gokulg846/compact-edge-enclosure/report/walkthrough.md

# A five-minute explanation

Use the current report and CAD images. The goal is to explain the design, not recite the file count.

**0:00–0:40 — State the problem.** “This is a digital study of a small enclosure for an assumed electronics board. The main constraints are a 100 × 70 × 25 mm housing, removable electronics and an 8 W heat-load scenario. These are design inputs, not measurements of a commercial device.” Show the assembly image.

**0:40–1:25 — Explain the parts.** Show the exploded view. “The tray supports the board and provides mounting and connector access. The lid has an underside contact block and external fins. A compliant pad connects the chip to that block. Four screws let the lid come off for service.” Point to each part. Explain that the inspection fixture is separate tooling, not part of the product.

**1:25–2:10 — Explain the difficult gap.** Show the section drawing. “The nominal thermal gap is 0.50 mm. The proposed tolerance stack gives 0.31–0.69 mm. That matters because pad compression creates force on the board. A nominal thickness alone is insufficient to select the pad.” Show how the dimensions subtract; do not claim a pad supplier or pressure test.

**2:10–3:05 — Explain the thermal assumptions.** “The original resistance scenarios give93.4°C passive and61.4°C with the lower fan resistance, at 8 W and35°C ambient. Those are conditional calculations. I added a geometric area check: the modeled lid path needs an effective heat-transfer coefficient of about 26.5 W/(m² K) to meet80°C under the stated assumptions. Actual airflow and fin efficiency are not established.” Show the design-study plot and name its simplifications.

**3:05–3:50 — Explain a real tradeoff.** “I rebuilt a four-fin option and a taller-fin option. Four fins give wider tool channels but less exposed area. Taller fins add area but make the housing 29 mm high. Eight fins leave 2 mm channels, below the chosen 3 mm cutter constraint. The six-fin design remains the baseline, not a proven optimum.” Open the candidate result table.

**3:50–4:25 — Explain manufacturing intent.** Show the setup diagram. “The tray needs a top pocket, an underside finishing setup and a side connector operation. The thin thermal lid needs support while machining its second side. These are process proposals. No machine-specific CAM, feeds/speeds or proved toolpaths are claimed.”

**4:25–5:00 — Explain evidence and scope.** “The source regenerates the geometry and reports. Solid checks verify nominal shape validity and overlap; software tests verify specific calculations and input rules. They do not prove strength, actual temperatures or manufacturability. This project is a digital design study with its open decisions documented.” Mention AI assistance accurately if discussing how it was produced; focus on decisions you can personally explain and reproduce.

## Before presenting

Be able to answer: Why is the lid removable? What are the four layers? Why does the pad gap matter? Where did 8 W come from? Which temperature is being estimated? Why was the eight-fin candidate rejected? What does a passing interference check fail to establish? The answers are in START_HERE.md and analysis/design-study.md.
