gokulg846/compact-edge-enclosure/report/sources.md

# Public context and technical sources

Accessed 2026-10-09. Company pages informed the problem context only; no geometry was copied and no undisclosed specifications were inferred.

- [comma.ai home](https://comma.ai/): camera-based driver-assistance hardware context.
- [Introducing comma four](https://blog.comma.ai/comma-four/), published 2025-11-25: describes mechanical/thermal redesign, compact integration and San Diego manufacture. This motivated studying packaging, thermal paths and assembly; it does not establish dimensions or heat loads for this project.
- [comma.ai shop](https://comma.ai/shop): product context; prices/specifications are not design inputs here.
- [commaai/hardware](https://github.com/commaai/hardware): public hardware repository reviewed as a contextual reference. No CAD assets imported.
- [comma.ai jobs](https://comma.ai/jobs): current public page lists Prototyping Engineer in San Diego. The Haas reference is supplied by the user's brief; the public listing inspected did not substantiate a machine configuration.
- [Haas VF-2](https://www.haascnc.com/machines/vertical-mills/vf-series/models/small/vf-2.html): reference machine family only. Actual configuration must be checked at the shop.
- [CadQuery quick start](https://cadquery.readthedocs.io/en/latest/quickstart.html) and [import/export documentation](https://cadquery.readthedocs.io/en/latest/importexport.html): editable Python solids and genuine STEP/STL/DXF export workflow.

All performance resistances, tolerances, interface dimensions, fastener envelopes, weights/scores and acceptance targets in the project are declared engineering assumptions or proposals. No vendor pad/fan/material property is represented as verified without selection and datasheet review.
