gokulg846/compact-edge-enclosure/docs/review-notes.md

# Digital review / Rev C

This revision addresses the difficulty of understanding the first repository and corrects specific engineering/software issues. The nominal enclosure dimensions have not changed.

| Finding | Correction | Evidence |
|---|---|---|
| The front page emphasized artifact/test counts instead of the design | Replaced it with a short problem statement, results table and a three-document reading path | README and START_HERE |
| Dozens of individual screw and locator exports obscured the two custom parts | Grouped component STEP, mesh and profile exports; added a single fixture assembly | exports/ and build.py |
| Compressed source lines were difficult to read | Applied normal Python formatting and documented model/analysis entry points | CAD, analysis and scripts |
| `lid_boss_radius` no longer controlled the actual corner geometry | Replaced it with `corner_island_width`; shared the true cavity between CAD and SCAD generation | CAD regression test changes actual solid volume |
| A shifted lid pilot could be accepted without enough surrounding material | Added actual B-rep ring containment at all four lid pilots | A hole shifted into the pocket is rejected by a regression test |
| Pad-gap arithmetic duplicated hard-coded nominal dimensions | Derived nominal gap from the CAD parameters and moved tolerance assumptions to a named input file | Changing the CAD gap changes the analysis result in a regression test |
| A validation comment implied a cutter-collision check that did not exist | Corrected it to describe scalar radius/channel checks | validate.py; CAM limitations retained |
| The thermal scenarios lacked a link to fin geometry | Added exposed-area and required-conductance calculations plus rebuilt fin candidates | design-study.json and design-study.csv |
| Arbitrary parameter edits could leave report dimensions stale | Added a reviewed-input check before PDF generation | report input-guard test |
| Portfolio copy framed physical work as the required next milestone | Reframed the project as a bounded digital design study | README, report, summary and walkthrough |

The study still does not establish a real board interface, supplier-qualified pad behavior, actual convection, machining capability, thread strength or fixture repeatability. Digital rigor means stating those boundaries and checking the claims we can check; it does not mean labeling the product “perfect.”

No past physical work or engineering experience has been invented. The geometry and documents were developed with AI assistance and are intended for owner review and understanding before use in an application.
