gokulg846/compact-edge-enclosure/images/base_drawing.png

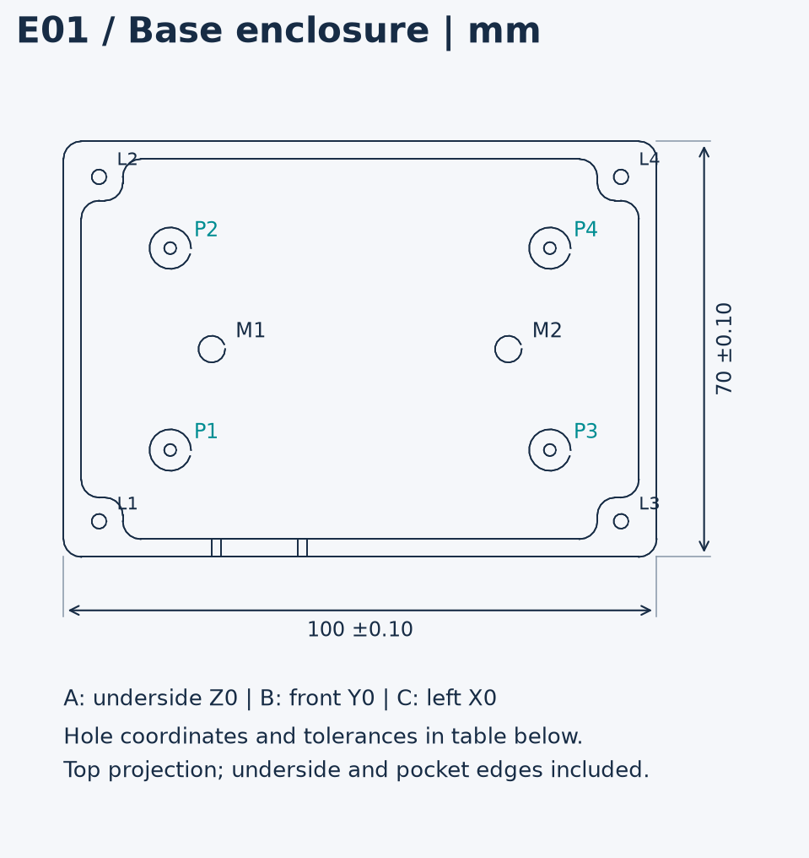
images/base_drawing.png
