gokulg846/compact-edge-enclosure/images/concept_matrix.png

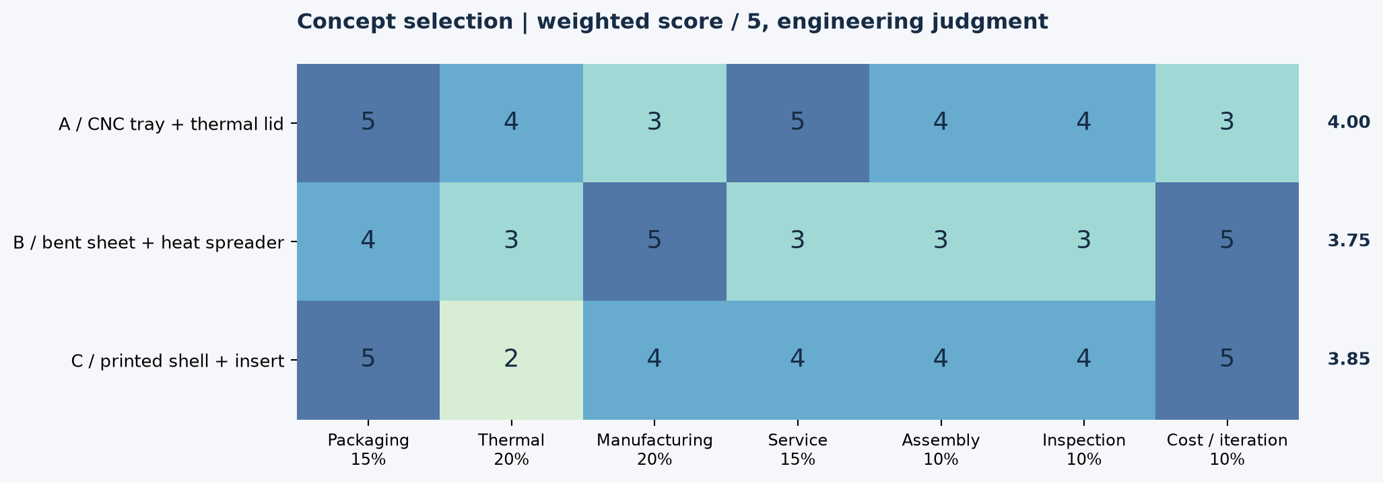
images/concept_matrix.png
