gokulg846/compact-edge-enclosure/images/dimensioned_plan.png

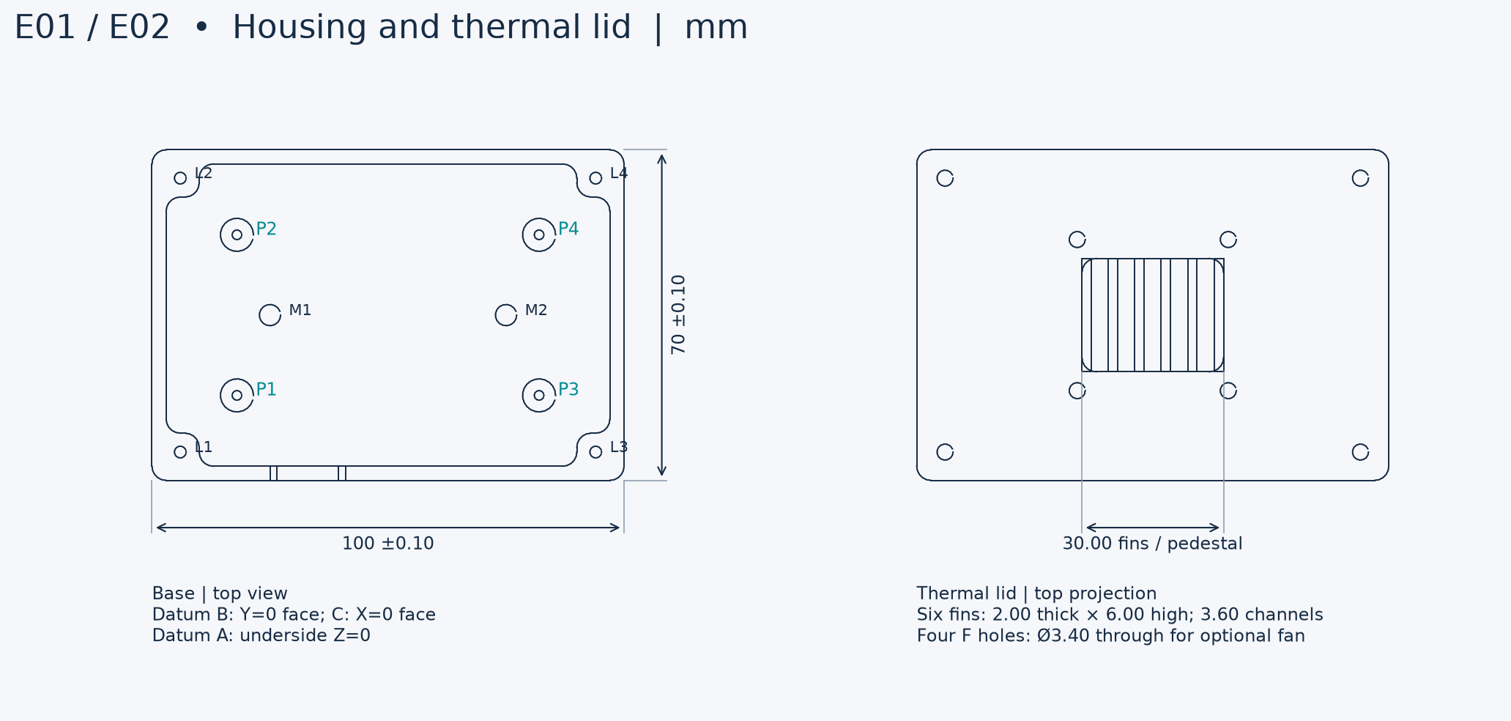
images/dimensioned_plan.png
