gokulg846/compact-edge-enclosure/images/dimensioned_section.png

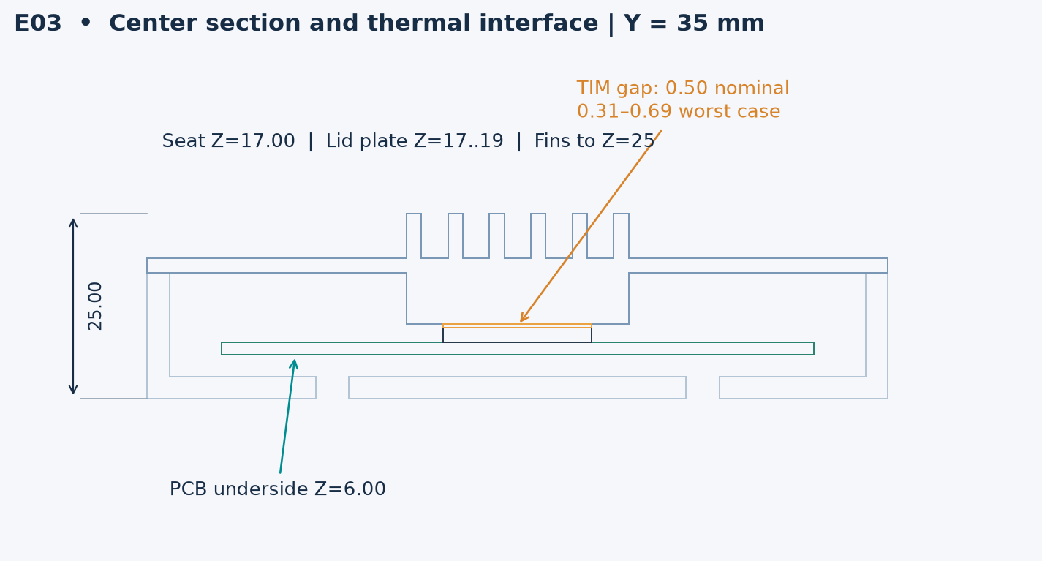
images/dimensioned_section.png
