gokulg846/compact-edge-enclosure/images/fixture_layout.png

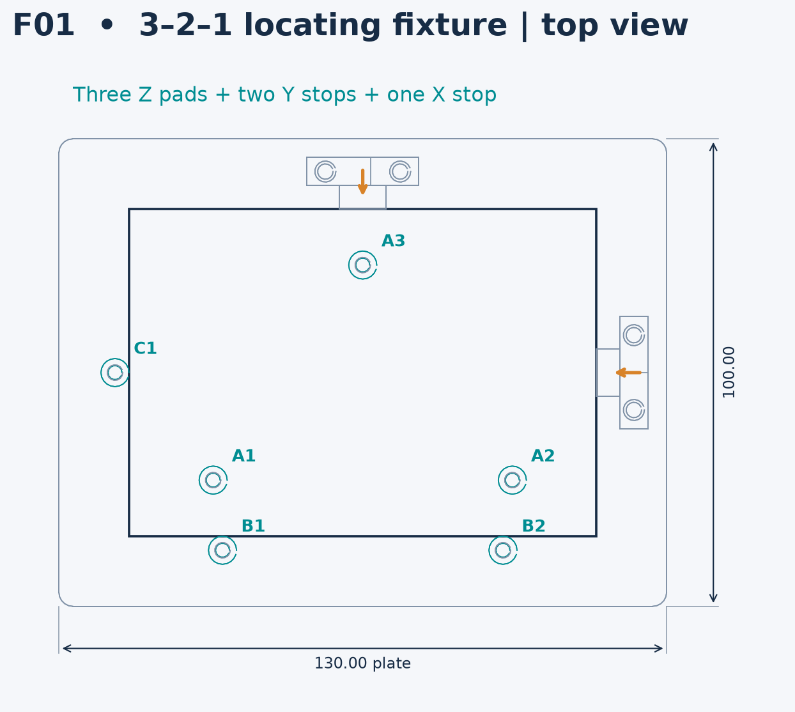
images/fixture_layout.png
