gokulg846/compact-edge-enclosure/images/forced_air.png

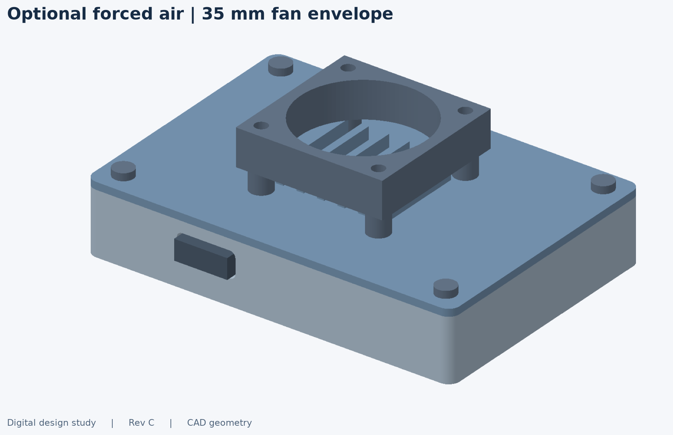
images/forced_air.png
