gokulg846/compact-edge-enclosure/images/thermal_lid_drawing.png

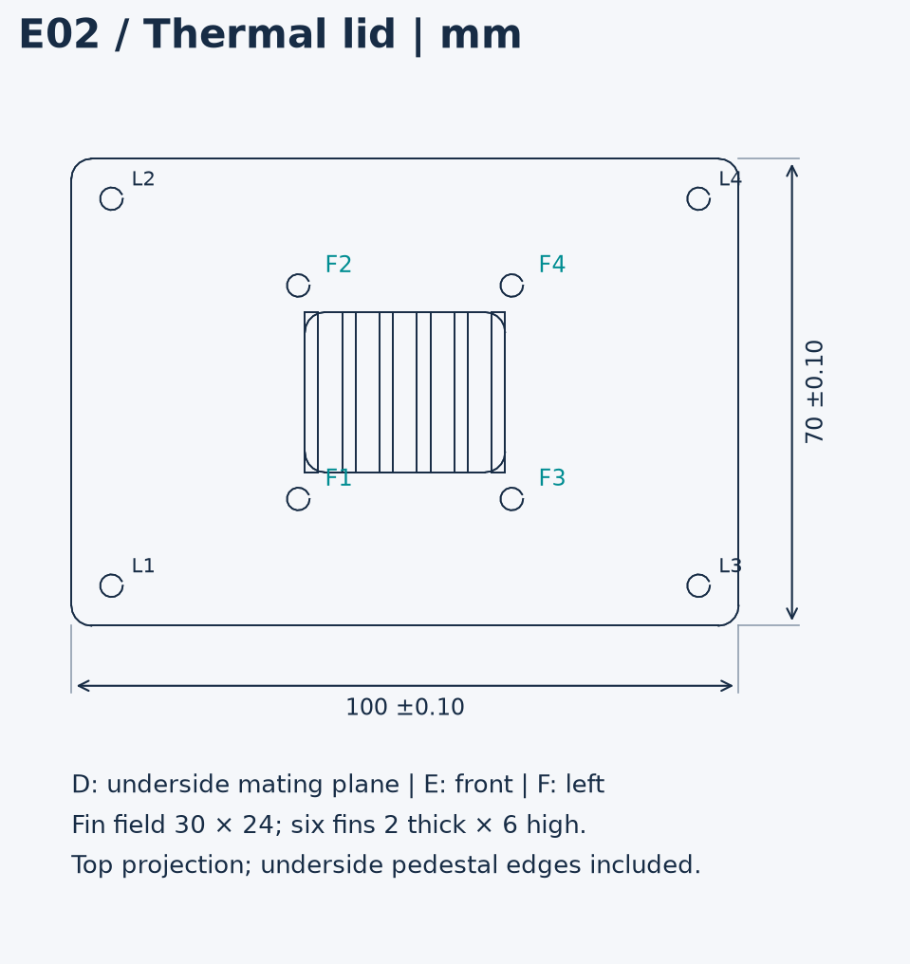
images/thermal_lid_drawing.png
