gokulg846/compact-edge-enclosure/images/thermal_sensitivity.png

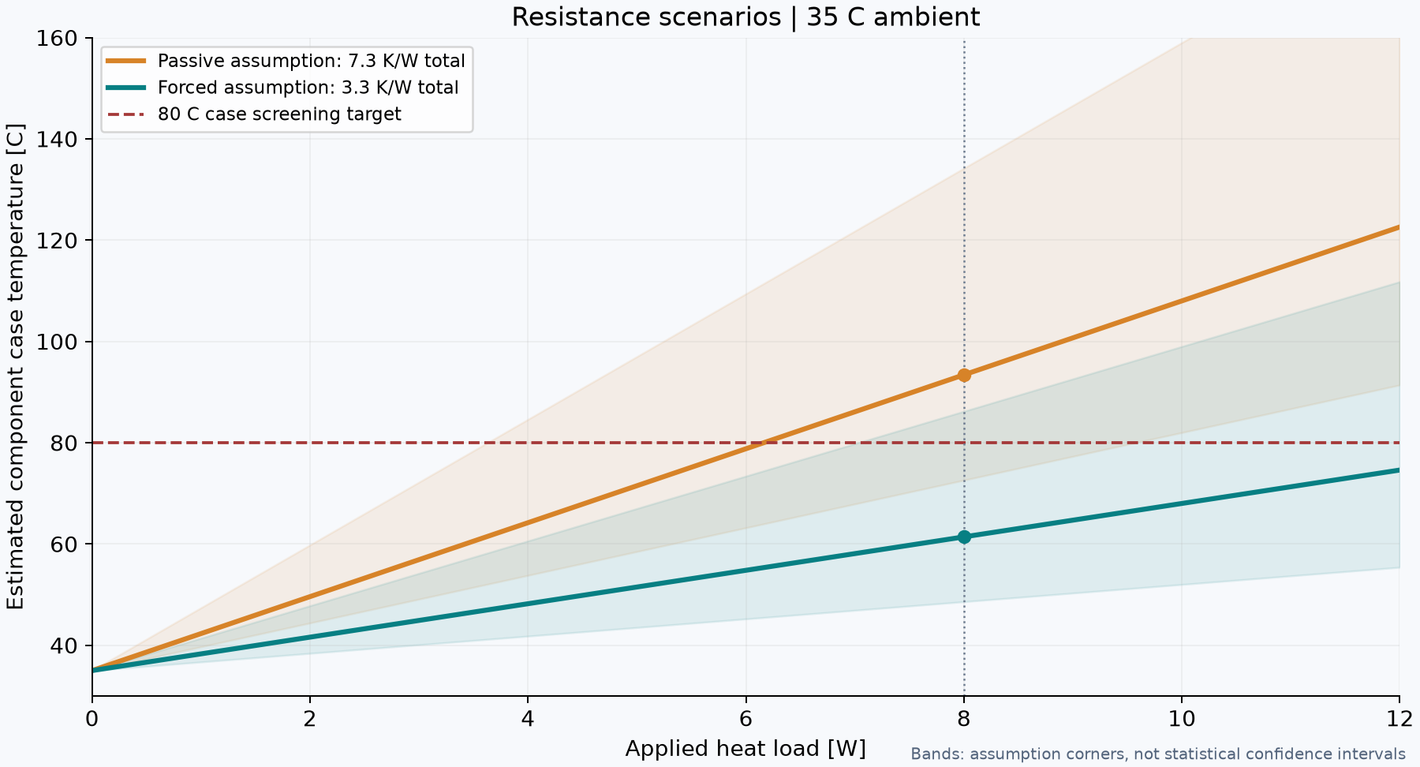
images/thermal_sensitivity.png
