gokulg846/compact-edge-enclosure/manufacturing/bom.md

# Candidate bill of materials / no purchase or build claimed

| Qty | Item | Geometry / selection note |
|---:|---|---|
| 1 | CNC tray | 6061-T6; exports/base.step; replace with fit print initially |
| 1 | Integral thermal lid | 6061-T6; exports/thermal_lid.step; printed copy is dummy only |
| 1 | Generic board coupon | 80 × 50 × 1.6; hole pattern64 × 34; not a real compute board specification |
| 1 | Dummy chip / heater block | 20 × 20 × 2 envelope; heater and electrical ratings to be selected |
| 1 | Thermal pad | 20 × 20; free 1 mm assumed; supplier compression/pressure/temperature data required |
| 4 | M3 × 8 lid screws | Selected head envelope ≤Ø5.5 × 2 assumed; verify actual fastener |
| 4 | M2.5 × 5 PCB screws | Head envelope ≤Ø4.5 × 1.7 assumed; verify actual fastener |
| 2 | M4 external mount bolts | Length to external bracket; head height ≤2.5; bracket/nuts not included |
| 1 optional | Generic fan | 40 × 40 × 10; pitch 32; actual fan/guard/power/flow not selected |
| 4 optional | Fan spacers | Length6; OD6; ID3.4 |
| 4 sets optional | Fan M3 bolts/nuts | Nominal grip 18 mm plus washers/nut; select length after measuring actual hardware |
| 1 | Fixture plate | 130 × 100 × 6; exports/components/fixture_plate.step |
| 6 | Replaceable locator buttons | Ø6 shoulders, simplifiedØ3 stems; three 4 mm and three 9 mm above plate |
| 6 sets | Locator nuts/washers/shims | Selected to fit4 mm stem protrusion beneath plate; raise bench fixture for access |
| 2 | Lateral clamp blocks | Modeled mounting and horizontal screw bores; M4 hardware to be selected |
| 2 | Replaceable clamp pads | Nylon/acetal candidate, low force; swivel attachment requires selection |
| 4 | Clamp-block mounting screws | M4 clearance blocks to tapped plate; select length against6 mm plate thickness |
| 2 | Clamp drive screws | M4; verify travel, pad attachment and applied force |
| As needed | Bench feet / light hold-down | Not modeled; required where nuts need clearance or assembly torque could lift tray |

No supplier pricing or lead-time quote has been obtained. Print cost is dominated by material/time; CNC cost by setup count and thin-lid fixturing. Obtain quotes using the STEP files plus review drawings after real interfaces are frozen.
