gokulg846/compact-edge-enclosure/exports/assembly.step

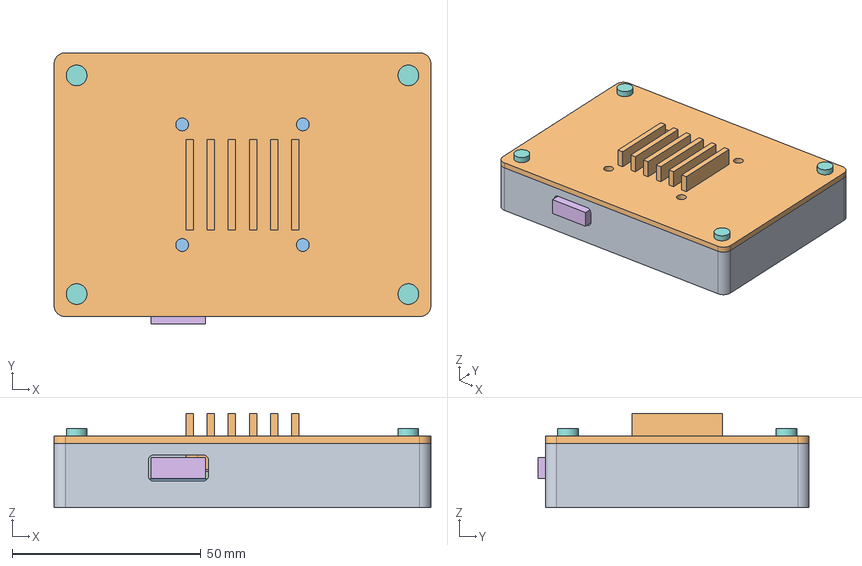
[picture p26: CAD file, 2026-10-09]
exports/assembly.step
100.0 x 72.0 x 25.0 mm
base
thermal_lid
pcb
chip
thermal_pad
connector
component_keepout
lid_screw_1
lid_screw_2
lid_screw_3
lid_screw_4
pcb_screw_1
pcb_screw_2
pcb_screw_3
pcb_screw_4
