gokulg846/compact-edge-enclosure/exports/forced_air_assembly.step

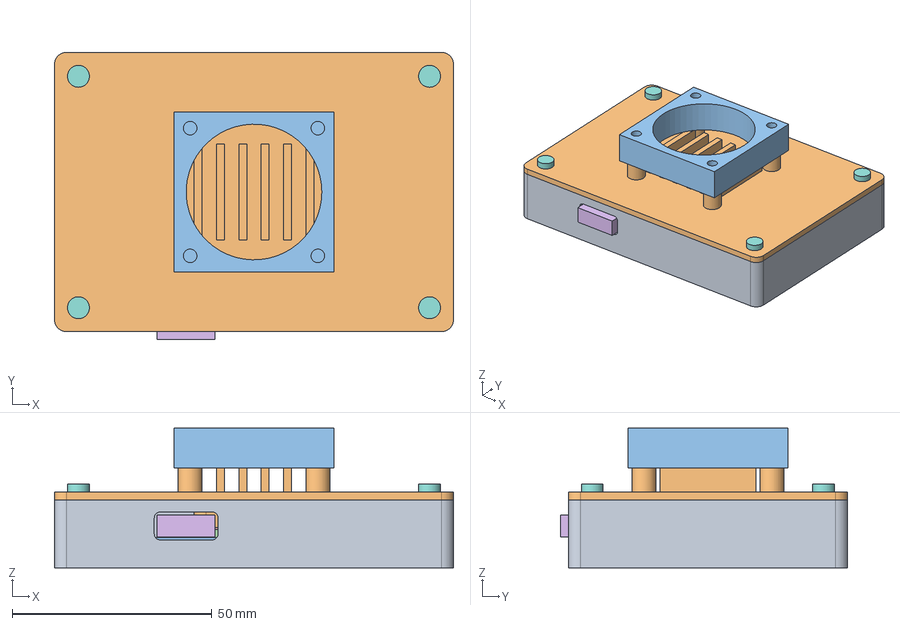
[picture p27: CAD file, 2026-10-09]
exports/forced_air_assembly.step
100.0 x 72.0 x 35.0 mm
base
thermal_lid
pcb
chip
thermal_pad
connector
component_keepout
lid_screw_1
lid_screw_2
lid_screw_3
lid_screw_4
pcb_screw_1
pcb_screw_2
pcb_screw_3
pcb_screw_4
fan_spacer_1
fan_spacer_2
fan_spacer_3
fan_spacer_4
fan_envelope
