gokulg846/compact-edge-enclosure/exports/fixture_assembly.step

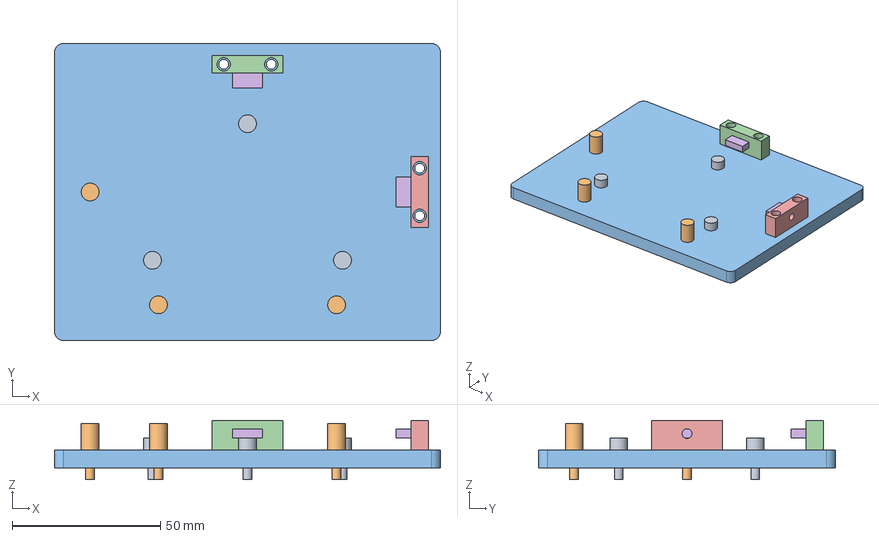
[picture p28: CAD file, 2026-10-09]
exports/fixture_assembly.step
130.0 x 100.0 x 20.0 mm
locator_1
locator_2
locator_3
locator_4
locator_5
locator_6
fixture_plate
clamp_y
clamp_x
clamp_pad_y
clamp_pad_x
