gokulg846/compact-edge-enclosure/exports/components/locator_6.step

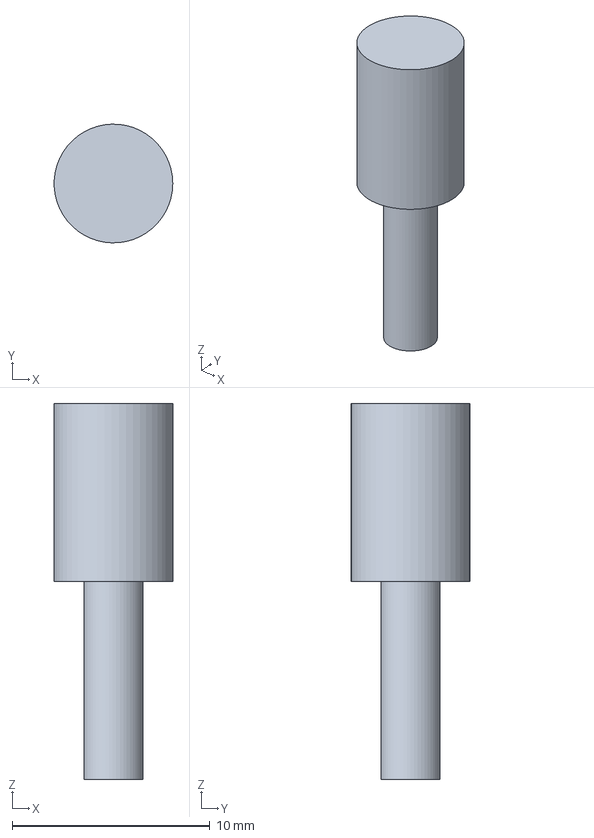
[picture p29: CAD file, 2026-10-09]
exports/components/locator_6.step
5.99 x 6.00 x 19.0 mm
