gokulg846/compact-edge-enclosure/exports/meshes/clamp_pad_y.stl

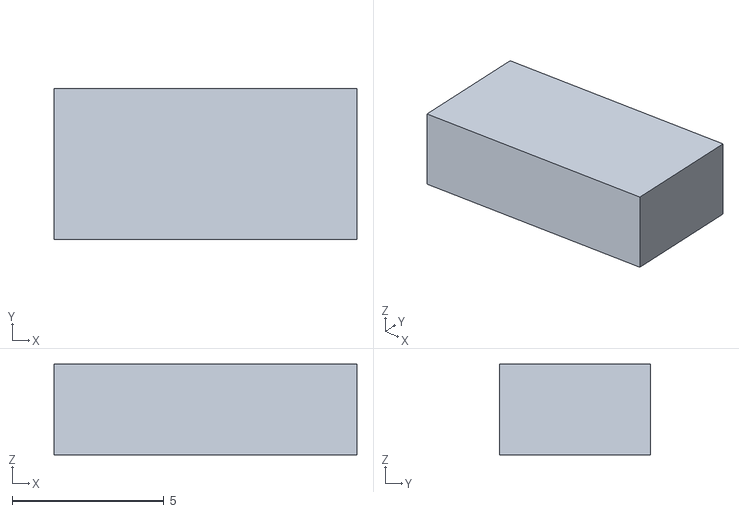
[picture p30: CAD file, 2026-10-09]
exports/meshes/clamp_pad_y.stl
10.0 x 5.00 x 3.00
