gokulg846/compact-edge-enclosure/exports/profiles/base_section.dxf

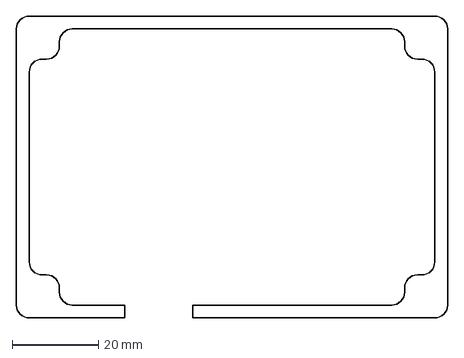
[picture p31: CAD file, 2026-10-09]
exports/profiles/base_section.dxf
100.0 x 70.0 mm
