gokulg846/compact-edge-enclosure/exports/studies/six_fins_6mm.step

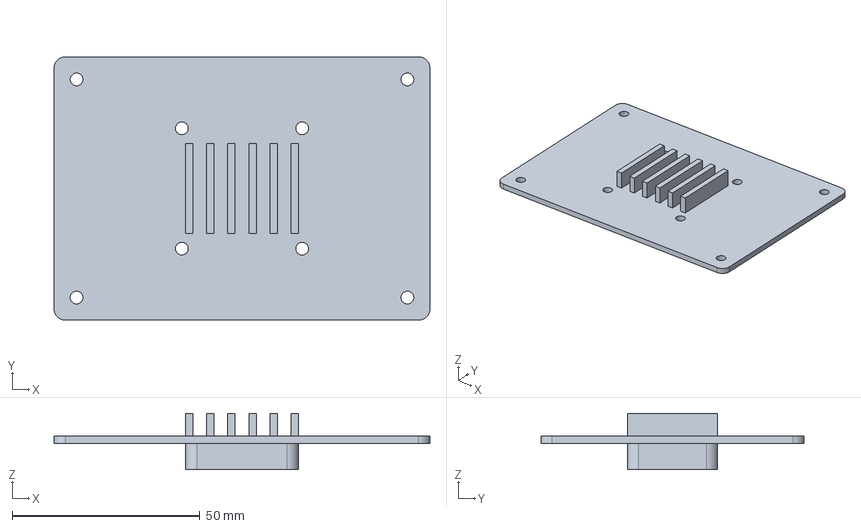
[picture p32: CAD file, 2026-10-09]
exports/studies/six_fins_6mm.step
100.0 x 70.0 x 14.9 mm
