gokulg846/compact-edge-enclosure/exports/profiles/thermal_lid_section.dxf

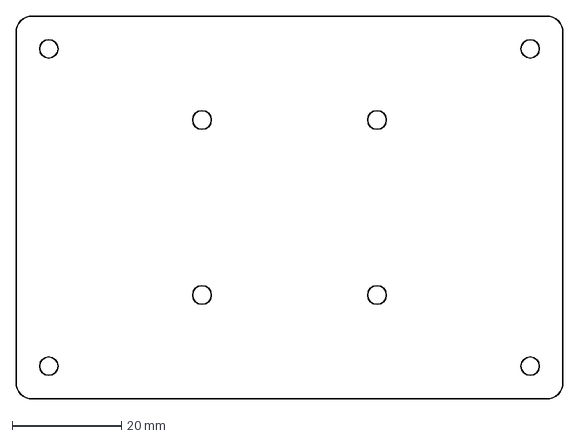
[picture p33: CAD file, 2026-10-09]
exports/profiles/thermal_lid_section.dxf
100.0 x 70.0 mm
