gokulg846/compact-edge-enclosure/exports/components/fan_spacer_2.step

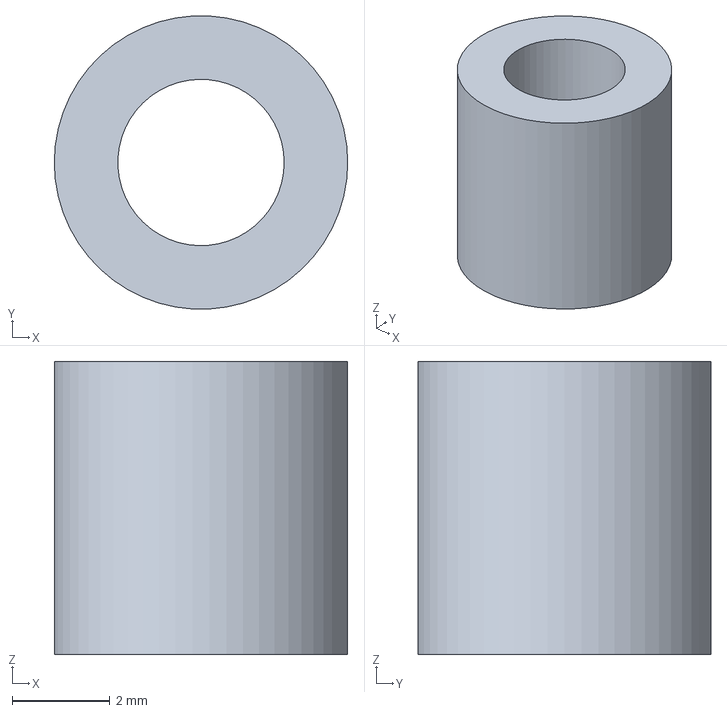
[picture p34: CAD file, 2026-10-09]
exports/components/fan_spacer_2.step
6.00 x 5.99 x 6.00 mm
