gokulg846/compact-edge-enclosure/exports/studies/six_fins_10mm.step

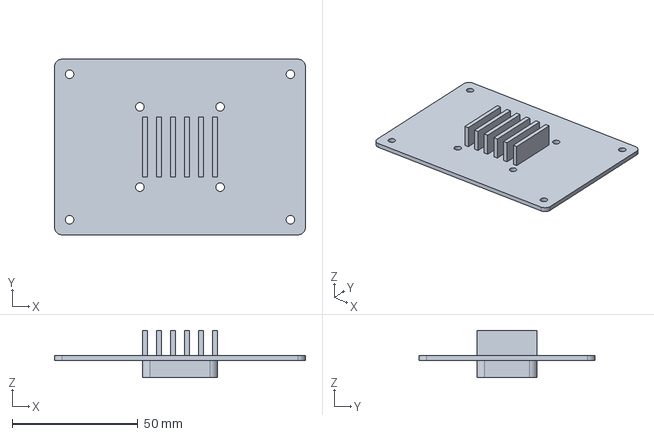
[picture p35: CAD file, 2026-10-09]
exports/studies/six_fins_10mm.step
100.0 x 70.0 x 18.9 mm
