gokulg846/compact-edge-enclosure/exports/meshes/pcb.stl

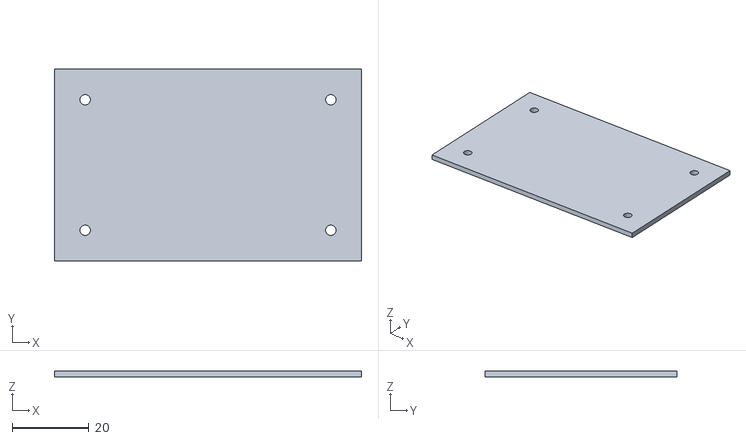
[picture p36: CAD file, 2026-10-09]
exports/meshes/pcb.stl
80.0 x 50.0 x 1.60
