gokulg846/compact-edge-enclosure/exports/base.step

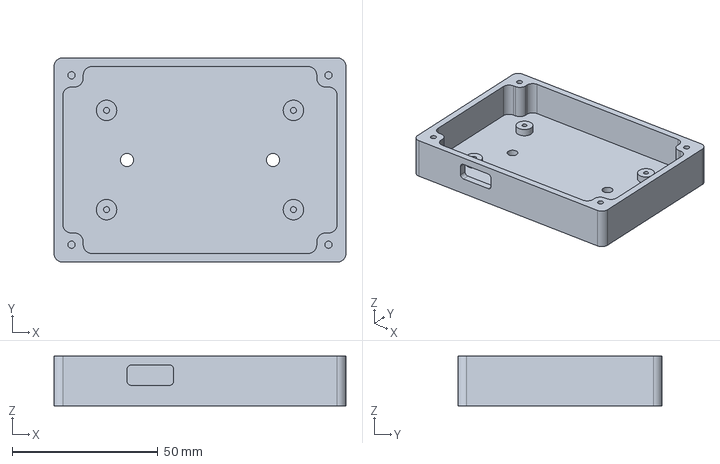
[picture p37: CAD file, 2026-10-09]
exports/base.step
100.0 x 70.0 x 17.0 mm
