gokulg846/compact-edge-enclosure/exports/components/thermal_pad.step

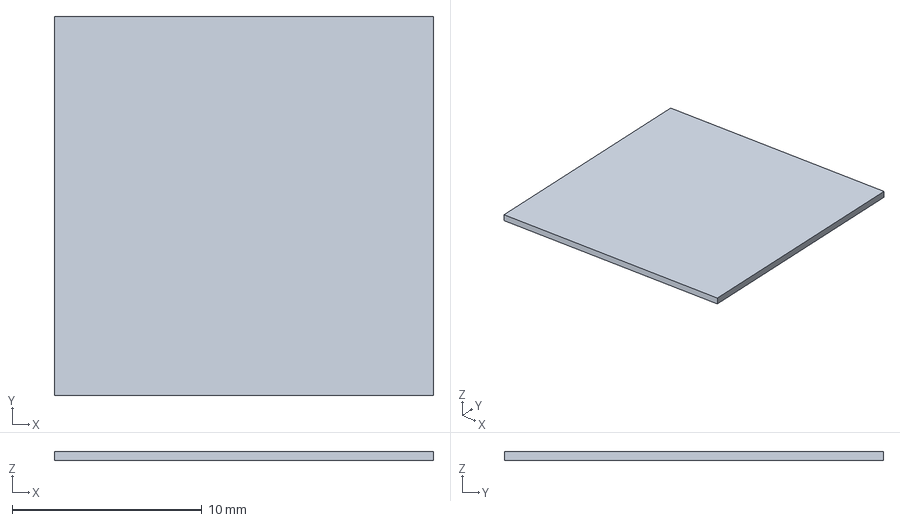
[picture p38: CAD file, 2026-10-09]
exports/components/thermal_pad.step
20.0 x 20.0 x 0.5 mm
