gokulg846/compact-edge-enclosure/exports/meshes/component_keepout.stl

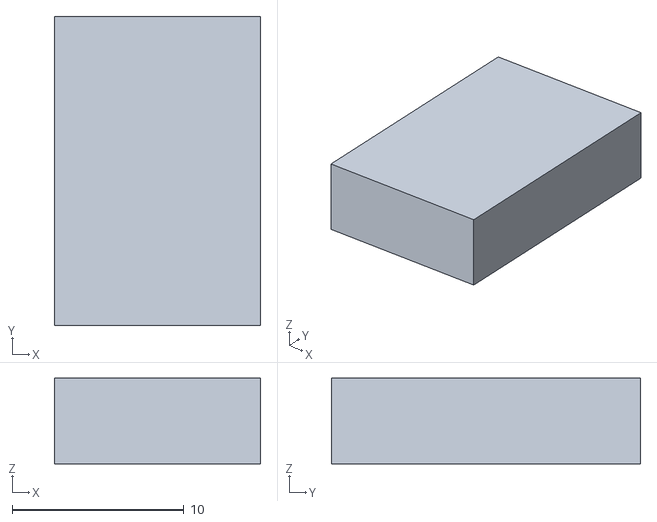
[picture p39: CAD file, 2026-10-09]
exports/meshes/component_keepout.stl
12.0 x 18.0 x 5.00
