gokulg846/compact-edge-enclosure/exports/meshes/clamp_x.stl

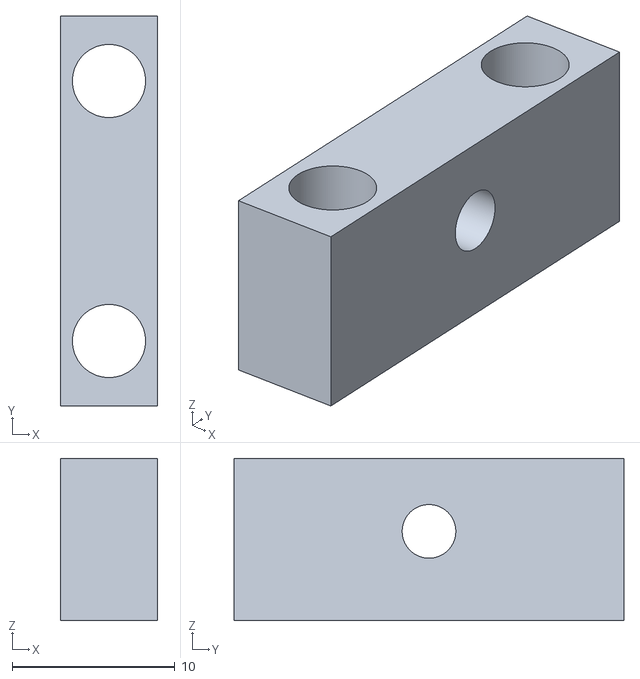
[picture p40: CAD file, 2026-10-09]
exports/meshes/clamp_x.stl
6.00 x 24.0 x 10.0
