gokulg846/compact-edge-enclosure/exports/meshes/connector.stl

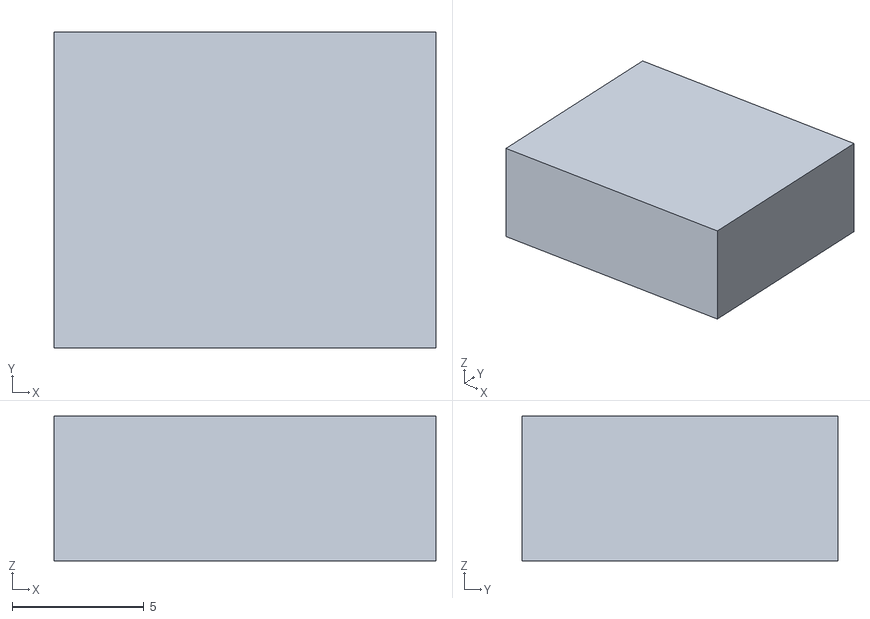
[picture p41: CAD file, 2026-10-09]
exports/meshes/connector.stl
14.5 x 12.0 x 5.50
