gokulg846/compact-edge-enclosure/exports/components/locator_3.step

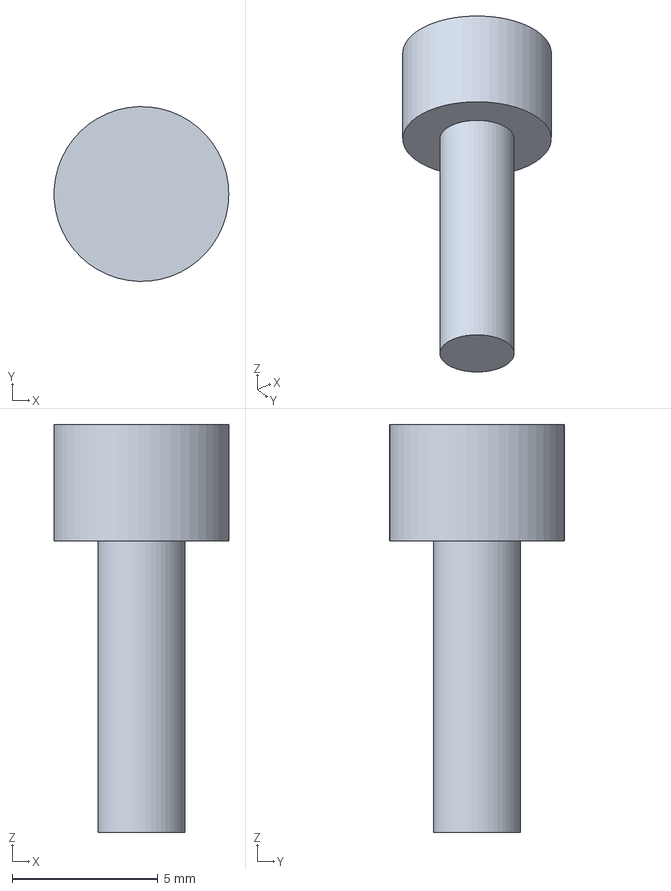
[picture p42: CAD file, 2026-10-09]
exports/components/locator_3.step
5.99 x 6.00 x 14.0 mm
