gokulg846/compact-edge-enclosure/exports/meshes/fan_envelope.stl

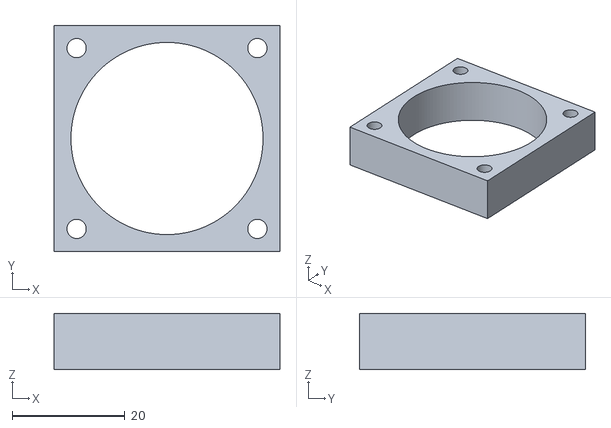
[picture p43: CAD file, 2026-10-09]
exports/meshes/fan_envelope.stl
40.0 x 40.0 x 10.0
