gokulg846/compact-edge-enclosure/exports/components/fixture_plate.step

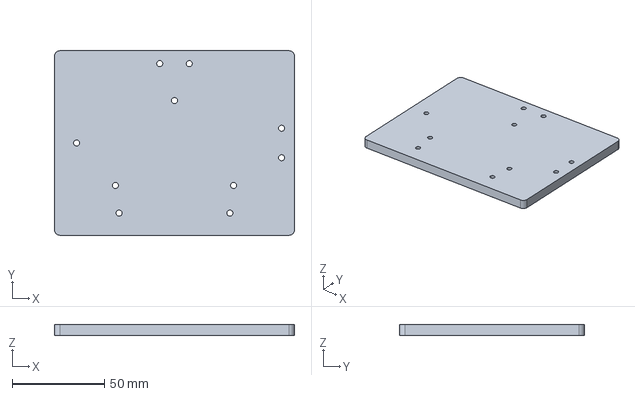
[picture p44: CAD file, 2026-10-09]
exports/components/fixture_plate.step
130.0 x 100.0 x 6.00 mm
