gokulg846/compact-edge-enclosure/exports/components/chip.step

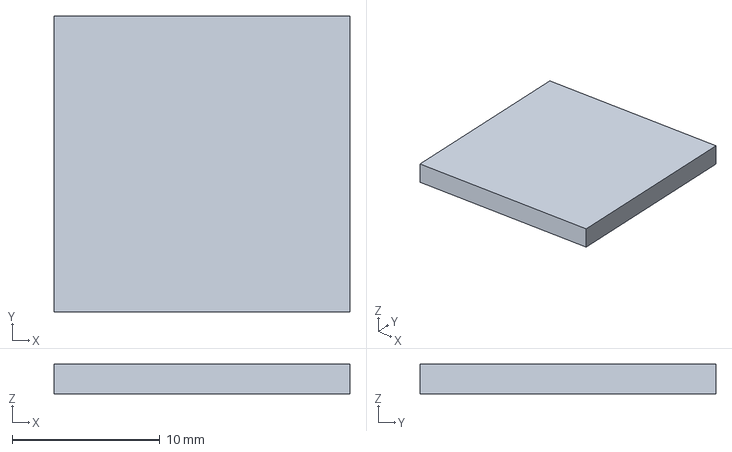
[picture p45: CAD file, 2026-10-09]
exports/components/chip.step
20.0 x 20.0 x 2.00 mm
