gokulg846/compact-edge-enclosure/cad/generated_parameters.scad

// Generated from parameters.json by scripts/scad.py. Units mm.
length = 100.0;
width = 70.0;
height = 25.0;
wall = 3.0;
floor = 3.0;
lid_thickness = 2.0;
fin_height = 6.0;
fin_count = 6;
fin_thickness = 2.0;
corner_radius = 3.0;
pocket_radius = 3.0;
board_length = 80.0;
board_width = 50.0;
board_thickness = 1.6;
board_x = 10.0;
board_y = 10.0;
support_height = 3.0;
board_hole_pitch_x = 64.0;
board_hole_pitch_y = 34.0;
board_hole_diameter = 2.7;
pcb_tap_drill = 2.05;
lid_screw_inset = 6.0;
lid_screw_clearance = 3.4;
lid_tap_drill = 2.5;
support_radius = 3.5;
chip_length = 20.0;
chip_width = 20.0;
chip_height = 2.0;
pad_compressed = 0.5;
pad_free = 1.0;
sink_length = 30.0;
sink_width = 24.0;
component_height = 5.0;
minimum_clearance = 1.0;
connector_x = 25.0;
connector_width = 16.0;
connector_bottom = 7.0;
connector_height = 7.0;
connector_radius = 1.5;
cable_keepout = 30.0;
mount_pitch = 50.0;
mount_hole_diameter = 4.5;
fan_enabled = false;
fan_size = 40.0;
fan_pitch = 32.0;
fan_height = 10.0;
material = "6061-T6 aluminum";
process = "CNC planning";
corner_island_width = 10.0;
body = 17.0;
board_z = 6.0;
chip_z = 7.6;
pad_z = 9.6;
ped_z = 10.1;
lid_holes = [[6.0, 6.0], [6.0, 64.0], [94.0, 6.0], [94.0, 64.0]];
pcb_holes = [[18.0, 18.0], [18.0, 52.0], [82.0, 18.0], [82.0, 52.0]];
fan_holes = [[34.0, 19.0], [34.0, 51.0], [66.0, 19.0], [66.0, 51.0]];
mounts = [[25.0, 35.0], [75.0, 35.0]];
pocket_outline = [[87.0, 3.0], [13.0, 3.0], [12.70595, 3.01445], [12.41473, 3.05764], [12.12915, 3.12918], [11.85195, 3.22836], [11.58581, 3.35424], [11.33329, 3.50559], [11.09682, 3.68097], [10.87868, 3.87868], [10.68097, 4.09682], [10.50559, 4.33329], [10.35424, 4.58581], [10.22836, 4.85195], [10.12918, 5.12915], [10.05764, 5.41473], [10.01445, 5.70595], [10.0, 6.0], [10.0, 7.0], [9.98555, 7.29405], [9.94236, 7.58527], [9.87082, 7.87085], [9.77164, 8.14805], [9.64576, 8.41419], [9.49441, 8.66671], [9.31903, 8.90318], [9.12132, 9.12132], [8.90318, 9.31903], [8.66671, 9.49441], [8.41419, 9.64576], [8.14805, 9.77164], [7.87085, 9.87082], [7.58527, 9.94236], [7.29405, 9.98555], [7.0, 10.0], [6.0, 10.0], [5.70595, 10.01445], [5.41473, 10.05764], [5.12915, 10.12918], [4.85195, 10.22836], [4.58581, 10.35424], [4.33329, 10.50559], [4.09682, 10.68097], [3.87868, 10.87868], [3.68097, 11.09682], [3.50559, 11.33329], [3.35424, 11.58581], [3.22836, 11.85195], [3.12918, 12.12915], [3.05764, 12.41473], [3.01445, 12.70595], [3.0, 13.0], [3.0, 57.0], [3.01445, 57.29405], [3.05764, 57.58527], [3.12918, 57.87085], [3.22836, 58.14805], [3.35424, 58.41419], [3.50559, 58.66671], [3.68097, 58.90318], [3.87868, 59.12132], [4.09682, 59.31903], [4.33329, 59.49441], [4.58581, 59.64576], [4.85195, 59.77164], [5.12915, 59.87082], [5.41473, 59.94236], [5.70595, 59.98555], [6.0, 60.0], [7.0, 60.0], [7.29405, 60.01445], [7.58527, 60.05764], [7.87085, 60.12918], [8.14805, 60.22836], [8.41419, 60.35424], [8.66671, 60.50559], [8.90318, 60.68097], [9.12132, 60.87868], [9.31903, 61.09682], [9.49441, 61.33329], [9.64576, 61.58581], [9.77164, 61.85195], [9.87082, 62.12915], [9.94236, 62.41473], [9.98555, 62.70595], [10.0, 63.0], [10.0, 64.0], [10.01445, 64.29405], [10.05764, 64.58527], [10.12918, 64.87085], [10.22836, 65.14805], [10.35424, 65.41419], [10.50559, 65.66671], [10.68097, 65.90318], [10.87868, 66.12132], [11.09682, 66.31903], [11.33329, 66.49441], [11.58581, 66.64576], [11.85195, 66.77164], [12.12915, 66.87082], [12.41473, 66.94236], [12.70595, 66.98555], [13.0, 67.0], [87.0, 67.0], [87.29405, 66.98555], [87.58527, 66.94236], [87.87085, 66.87082], [88.14805, 66.77164], [88.41419, 66.64576], [88.66671, 66.49441], [88.90318, 66.31903], [89.12132, 66.12132], [89.31903, 65.90318], [89.49441, 65.66671], [89.64576, 65.41419], [89.77164, 65.14805], [89.87082, 64.87085], [89.94236, 64.58527], [89.98555, 64.29405], [90.0, 64.0], [90.0, 63.0], [90.01445, 62.70595], [90.05764, 62.41473], [90.12918, 62.12915], [90.22836, 61.85195], [90.35424, 61.58581], [90.50559, 61.33329], [90.68097, 61.09682], [90.87868, 60.87868], [91.09682, 60.68097], [91.33329, 60.50559], [91.58581, 60.35424], [91.85195, 60.22836], [92.12915, 60.12918], [92.41473, 60.05764], [92.70595, 60.01445], [93.0, 60.0], [94.0, 60.0], [94.29405, 59.98555], [94.58527, 59.94236], [94.87085, 59.87082], [95.14805, 59.77164], [95.41419, 59.64576], [95.66671, 59.49441], [95.90318, 59.31903], [96.12132, 59.12132], [96.31903, 58.90318], [96.49441, 58.66671], [96.64576, 58.41419], [96.77164, 58.14805], [96.87082, 57.87085], [96.94236, 57.58527], [96.98555, 57.29405], [97.0, 57.0], [97.0, 13.0], [96.98555, 12.70595], [96.94236, 12.41473], [96.87082, 12.12915], [96.77164, 11.85195], [96.64576, 11.58581], [96.49441, 11.33329], [96.31903, 11.09682], [96.12132, 10.87868], [95.90318, 10.68097], [95.66671, 10.50559], [95.41419, 10.35424], [95.14805, 10.22836], [94.87085, 10.12918], [94.58527, 10.05764], [94.29405, 10.01445], [94.0, 10.0], [93.0, 10.0], [92.70595, 9.98555], [92.41473, 9.94236], [92.12915, 9.87082], [91.85195, 9.77164], [91.58581, 9.64576], [91.33329, 9.49441], [91.09682, 9.31903], [90.87868, 9.12132], [90.68097, 8.90318], [90.50559, 8.66671], [90.35424, 8.41419], [90.22836, 8.14805], [90.12918, 7.87085], [90.05764, 7.58527], [90.01445, 7.29405], [90.0, 7.0], [90.0, 6.0], [89.98555, 5.70595], [89.94236, 5.41473], [89.87082, 5.12915], [89.77164, 4.85195], [89.64576, 4.58581], [89.49441, 4.33329], [89.31903, 4.09682], [89.12132, 3.87868], [88.90318, 3.68097], [88.66671, 3.50559], [88.41419, 3.35424], [88.14805, 3.22836], [87.87085, 3.12918], [87.58527, 3.05764], [87.29405, 3.01445]];
