gokulg846/compact-edge-enclosure/(list of files, cad)

Other CAD files:
exports/thermal_lid.step
exports/components/thermal_lid.step
exports/studies/four_fins_6mm.step
exports/meshes/locator_4.stl
exports/components/component_keepout.step
exports/meshes/clamp_y.stl
exports/components/fan_spacer_1.step
exports/meshes/thermal_lid.stl
exports/components/fan_spacer_4.step
exports/meshes/base.stl
exports/meshes/locator_2.stl
exports/components/connector.step
exports/meshes/locator_3.stl
exports/components/clamp_pad_x.step
exports/components/locator_4.step
exports/meshes/locator_1.stl
exports/components/base.step
exports/meshes/fan_spacer_4.stl
exports/components/fan_spacer_3.step
exports/meshes/clamp_pad_x.stl
exports/components/locator_1.step
exports/components/fan_envelope.step
exports/meshes/fixture_plate.stl
exports/components/locator_2.step
exports/meshes/locator_5.stl
exports/meshes/fan_spacer_1.stl
exports/components/clamp_x.step
exports/meshes/fan_spacer_2.stl
exports/components/locator_5.step
exports/meshes/locator_6.stl
exports/components/clamp_y.step
exports/meshes/chip.stl
exports/meshes/fan_spacer_3.stl
exports/components/pcb.step
exports/components/clamp_pad_y.step
exports/meshes/thermal_pad.stl
exports/components/lid_screw_1.step
exports/components/lid_screw_2.step
exports/components/lid_screw_3.step
exports/components/lid_screw_4.step
exports/components/pcb_screw_1.step
exports/components/pcb_screw_2.step
exports/components/pcb_screw_3.step
exports/components/pcb_screw_4.step
exports/meshes/lid_screw_1.stl
exports/meshes/lid_screw_2.stl
exports/meshes/lid_screw_3.stl
exports/meshes/lid_screw_4.stl
exports/meshes/pcb_screw_1.stl
exports/meshes/pcb_screw_2.stl
exports/meshes/pcb_screw_3.stl
exports/meshes/pcb_screw_4.stl
