gokulg846/compact-edge-enclosure/images/cnc_setups.png

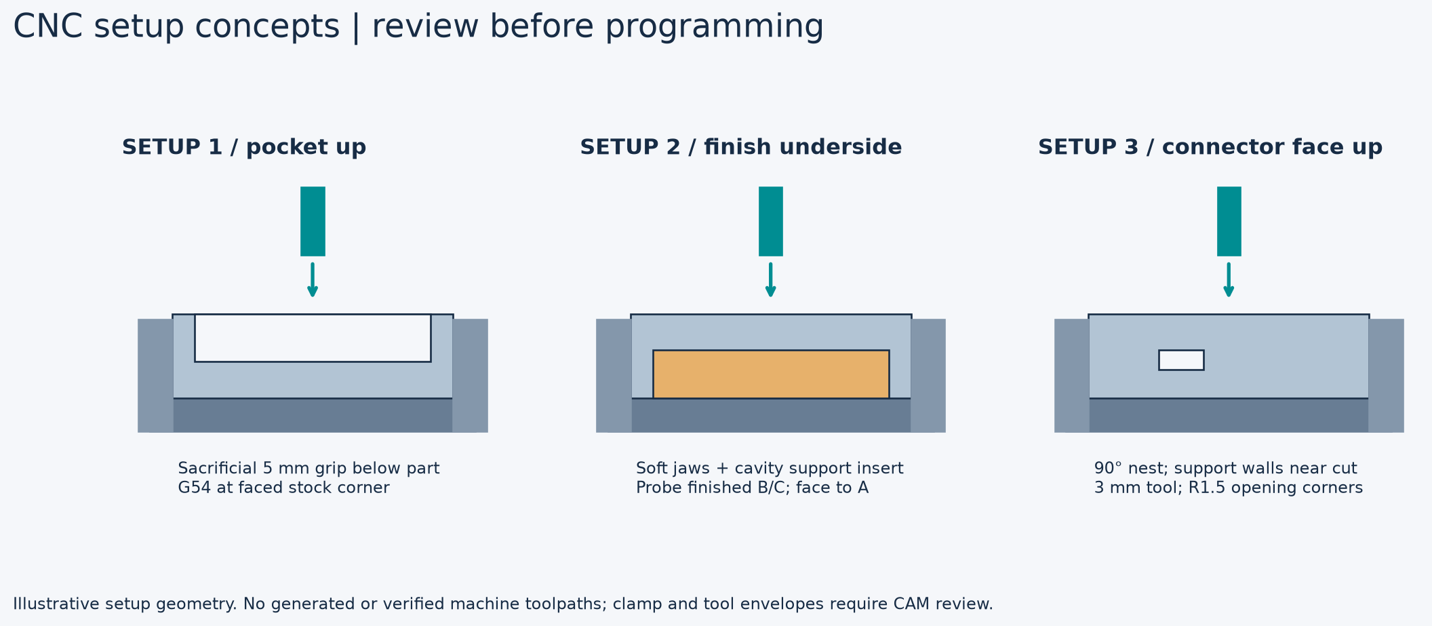
images/cnc_setups.png
