gokulg846/compact-edge-enclosure/report/release-notes.md

# Rev C — a clearer digital design study

Start with START_HERE.md. It explains the actual enclosure, the separate inspection fixture, what was calculated, and what the checks do and do not establish.

This revision keeps the nominal enclosure geometry and improves the review:

- Shorter README, a plain-language design guide and a simpler CAD download folder.
- Readable Python source with separate tray/lid construction functions.
- A real corner-island parameter and actual solid checks around the lid thread pilots.
- Thermal-pad gap calculated from CAD inputs, with an input guard for reviewed PDF dimensions.
- Three rebuilt fin candidates and one candidate rejected by the cutter-width constraint.
- Exposed-area and required-convection calculations that make the thermal assumptions explicit.
- Updated engineering report, drawings, portfolio summary and presentation script.

This is a digital-only mechanical-design study. Manufacturing and physical test procedures remain available as future handoff material. No fabrication, CFD, measured temperature, machining capability or fixture repeatability is claimed.
