gokulg846/compact-edge-enclosure/(commit log)

2026-10-09 Build EDGE 01 enclosure engineering demonstrator and validated portfolio package
    [assembly.step, base.step, base.stl, base_section.dxf, chip.step, chip.stl, clamp_pad_x.step, clamp_pad_x.stl]
2026-10-09 Clarify the digital design study and add geometry-backed fin comparisons
    [assembly.step, base.step, base.stl, base_section.dxf, chip.step, chip.stl, clamp_pad_x.step, clamp_pad_x.stl]
